sadekbaroudi/0xB2/(notices)

Notices in the files:
pcb/0xB2.kicad_pcb:
CERN-OHL-S v2
